absmach/quarc/docs/prd.md

# QUARC — Post-Quantum Secure Element

## Product Requirements Document v1.1 — 2025

### PROPRIETARY & CONFIDENTIAL

---

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

---

## Document Metadata

| Field | Value |
| --- | --- |
| Document | Quarc PRD v1.1 |
| Status | DRAFT |
| Classification | Public — open source |
| FPGA Board | ULX3S — Lattice ECP5-85K (84K LUTs) + BeagleV-Fire — PolarFire MPFS025T (23k LEs, Step 1) |
| CPU | Ibex RV32IMC (Apache 2.0, via sv2v + Yosys) |
| HDL Language | Verilog 2005 (all Quarc RTL) + sv2v for Ibex CPU only |
| Toolchain | Yosys + nextpnr + sv2v + SymbiYosys + Icarus — 100% open source |
| Build System | GNU Make — single Makefile |
| IP License Model | Apache-2.0 (firmware, tools, docs) + CERN-OHL-P 2.0 (RTL, gateware) — permissive OSS components only (MIT/ISC/BSD/Apache 2.0) |
| PQC Standards | FIPS 203 ML-KEM-768 \| FIPS 204 ML-DSA-65 |
| Comparable Product | TROPIC01 by Tropic Square — extended with PQC |
| Changelog | v1.1: PMP policy table, hardware key usage enforcement, device lifecycle model, secure boot rollback protection, NTT zeroization, entropy budgeting, bus protocol definition, concrete v1 use case |

---

## Table of Contents

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

---

## 1. Product Overview

### 1.1 Background and Motivation

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

### 1.2 What Quarc Is

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

### 1.3 What Quarc Is Not

- Not a clone of TROPIC01 — different crypto subsystem, same market positioning
- Not OpenTitan — deliberately lean, no SystemVerilog, no Bazel, fully open toolchain
- Not a finished product in v1 — v1 is an FPGA prototype proving architecture and PQC correctness
- Not a general-purpose MCU — Quarc is a cryptographic coprocessor, not a compute platform

### 1.4 Concrete v1 Use Case

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

```
1. Factory: Quarc generates ML-DSA keypair in slot 0 (device identity)
2. Factory: Quarc's verification key registered with update server
3. Field:   Update server generates new firmware, signs with its ML-DSA key
4. Field:   Host MCU initiates Quarc session (CHANNEL_INIT — Noise IK + ML-KEM hybrid)
5. Field:   Host sends firmware image + server signature to Quarc (FW_UPDATE)
6. Field:   Quarc verifies server signature using ML-DSA, checks rollback counter
7. Field:   Quarc flashes verified firmware, increments rollback counter
8. Field:   Host MCU requests device attestation (DSA_SIGN over device state)
9. Field:   Update server verifies device attestation using registered key
```

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

### 1.5 Competitive Positioning

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

---

## 2. Objectives

### 2.1 Primary Objectives (v1)

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

### 2.2 Secondary Objectives (v1)

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

### 2.3 Explicitly Out of Scope (v1)

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

---

## 3. Threat Model

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

### 3.1 Protected Assets

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

### 3.2 Threat Actors

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

### 3.3 Trust Boundary

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

**Inside the trust boundary:**

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

**Outside the trust boundary — treated as untrusted:**

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

### 3.4 Security Properties Required

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

---

## 4. System Architecture

### 4.1 Design Principles

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

### 4.2 SoC Architecture

```
Host MCU / Gateway (STM32, ESP32, any)
    |
    | SPI — encrypted Noise Protocol channel (ML-KEM + X25519 hybrid)
    |
    v
+------------------------------------------------------------+
|                    QUARC SoC (ECP5-85K)                    |
|                                                            |
|  Boot ROM (immutable)                                      |
|    → TRNG startup test                                     |
|    → PMP configure + lock (before firmware)               |
|    → ML-DSA verify firmware + rollback check              |
|    → jump to firmware                                      |
|                                                            |
|  Ibex RV32IMC  ←→  System Bus (Wishbone-lite, ~200 lines) |
|       |                                                    |
|  [Crypto Engine]     [Memory]          [Peripherals]       |
|  Keccak/SHAKE        IRAM (BRAM)       SPI slave           |
|  NTT engine          DRAM (BRAM)       UART (dev only)     |
|  ML-KEM ctrl         Boot ROM          Timer/WDT           |
|  ML-DSA ctrl         Key store ←─────── DMA only          |
|  TRNG + DRBG         (BRAM, HW access) Lifecycle reg       |
|  Key Usage Enforcer  Rollback counter  GPIO                |
+------------------------------------------------------------+

Key store access rule:
  Firmware:       NEVER reads key bytes — issues commands only
  Crypto engines: DMA key material directly from key store
  Bus decoder:    key store region blocked from firmware address space
```

### 4.3 Bus Architecture

Single-master Wishbone-lite bus. Ibex is the only bus master. All peripherals are bus slaves.

**Protocol:**

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

**DMA for crypto engines:**

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

**Formal verification targets for bus:**

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

### 4.4 Module Inventory and LUT Budget

> **Status:** The LUT estimates below date from the original single-partition
> plan and are **obsolete**. Measured synthesis after the ML-KEM hardware
> controller (`build/synth.log`) is **149,551 LUT4 + 58,901 FF** — the full
> hardware path exceeds both the ECP5-85K (84k) and PolarFire MPFS025T (23k).
> Quarc therefore uses a **two-step partition**: Step 1 (BeagleV-Fire, 23k)
> keeps crypto in C (`fw/mlkem_sw.c` over the SHA-3 + NTT MMIO engines) with a
> minimal fabric; Step 2 (ULX3S, 84k) returns the hardware ML-KEM/ML-DSA
> controllers, KUE, keystore, and SPI slave to fabric. See README § "Two-step
> deployment plan" for the authoritative partition. The table below documents
> the _estimated_ per-module cost for the Step 2 (hardware-accelerated) fabric.
> **Step 1 bring-up build** (ML-KEM + TRNG/DRBG removed, `build/synth_step1_v4.log`)
> measures **18,832 LUT4 + 10,554 FF** and fits the 23k MPFS025T.

| Module | Est. LUTs | Source | Notes |
| --- | --- | --- | --- |
| Ibex RV32IMC | ~3,500 | Apache 2.0 (OSS) | Control plane only. Not on crypto path. Synthesised via sv2v. |
| System Bus | ~200 | CERN-OHL-P 2.0 | Custom Wishbone-lite + formal verification. |
| Keccak/SHAKE engine | ~10,200 | CERN-OHL-P 2.0 | Shared by all consumers. Full-width 1600-bit round. |
| NTT engine (shared) | ~3,000 | CERN-OHL-P 2.0 | Parameterised for q=3329 and q=8380417. |
| ML-KEM-768 controller | ~1,500+ | CERN-OHL-P 2.0 | State machine. Drives NTT and Keccak engines. |
| ML-DSA-65 controller | ~2,000+ | CERN-OHL-P 2.0 | State machine. Rejection sampler. Drives NTT. |
| Key Usage Enforcer | ~200 | CERN-OHL-P 2.0 | HW policy engine. Enforces SIGN/DECAP/NO-EXPORT per slot. |
| TRNG | ~300 | CERN-OHL-P 2.0 | Ring oscillator. SP 800-90B RCT + APT health tests. |
| DRBG (SHAKE-256) | ~200 | CERN-OHL-P 2.0 | Auto-reseed from TRNG. Entropy budgeting enforced. |
| SPI slave | ~400 | CERN-OHL-P 2.0 | Mode 0/3. Command framing. 10 MHz target. |
| Key store controller | ~200 + BRAM | CERN-OHL-P 2.0 | BRAM-backed. DMA-only access from crypto engines. |
| Boot ROM | ~100 + BRAM | CERN-OHL-P 2.0 | Verilog ROM. PMP config. ML-DSA root key. Rollback counter. |
| Lifecycle state machine  | ~150 | CERN-OHL-P 2.0 | 4-state FSM. One-way transitions. HW enforced. |
| Rollback counter | ~100 | CERN-OHL-P 2.0 | Monotonic. BRAM-backed (v1). OTP in v2. |
| UART debug | ~200 | OSS (permissive) | Disabled in production bitstream. |
| Timer + WDT | ~150 | CERN-OHL-P 2.0 | RISC-V mtime/mtimecmp + 100ms watchdog. |
| IRAM / DRAM | BRAM only | Inferred | Separate address regions. No FPGA primitives. |
| **TOTAL (Step 2, est.)** | **~23,000+ LUT** | | Full-hardware path. Does NOT fit MPFS025T (23k); fits ECP5-85K. |

---

## 5. Security Policy

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

### 5.1 PMP Region Layout

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

**Boot sequence:**

```
Power on
  → TRNG health test (halt if fail)
  → Configure PMP regions 0–7
  → Set PMP LOCK bits on all regions
  → Load firmware from QSPI Flash into IRAM
  → ML-DSA.Verify(root_vk, fw_hash, fw_sig) — halt if fail
  → Check fw_version >= rollback_counter — halt if fail
  → Jump to firmware entry point
```

### 5.2 Hardware Key Usage Policy

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

**Key slot policy register (per slot, set at provisioning, hardware-enforced):**

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

**Operation flow (example: DSA_SIGN with slot 0):**

```
Firmware writes: KUE_CMD = {SIGN, slot=0, hash_ptr=...}
KUE checks:      slot 0 policy == SIGN_ONLY? → yes, proceed
KUE action:      DMA key bytes from key store → ML-DSA engine internal registers
                 (key bytes never appear on main bus)
KUE increments:  slot 0 use counter
ML-DSA engine:   performs signing using internal key registers
ML-DSA engine:   returns signature to output buffer (not key bytes)
KUE:             zeroises engine internal key registers after operation
Firmware reads:  signature from output buffer
```

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

### 5.3 Device Lifecycle Model

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

```
MANUFACTURING ──→ PROVISIONED ──→ LOCKED
      │                               │
      └──────────────────────────────→ RMA
```

**State definitions and command permissions:**

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

**Transition rules:**

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

### 5.4 Secure Boot Anti-Rollback

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

**Rollback counter:**

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

**Firmware header format (32-byte prefix, ML-DSA signature covers full image including header):**

```
[0:3]   magic       = 0x51415243  ("QARC")
[4:7]   fw_version  = monotonic integer, must be >= rollback_counter
[8:11]  fw_length   = length of firmware image in bytes
[12:15] reserved
[16:31] reserved
[32..]  firmware image
[end-2420..end]  ML-DSA-65 signature (2420 bytes) over bytes [0..end-2420]
```

### 5.5 NTT Scratchpad Zeroization

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

**Zeroization sequence:**

```
PQC operation completes
  → NTT controller asserts ZEROIZE signal
  → Counter walks through all scratchpad addresses: write 0x00000000
  → After all addresses zeroed: assert OP_DONE interrupt to Ibex
  → Firmware may now issue next command
```

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

### 5.6 Entropy Budget

PQC algorithms are entropy-hungry. The DRBG tracks entropy consumption per operation and enforces reseed policy.

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

**DRBG policy:**

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

---

## 6. Functional Requirements

### 6.1 ML-KEM Engine — FIPS 203, ML-KEM-768

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

#### 6.1.1 Required Operations

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

#### 6.1.2 Hardware Accelerated

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

#### 6.1.3 Security Requirements

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

---

### 6.2 ML-DSA Engine — FIPS 204, ML-DSA-65

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

#### 6.2.1 Required Operations

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

#### 6.2.2 Hardware Accelerated

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

#### 6.2.3 Security Requirements

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

---

### 6.3 Shared NTT Engine

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

---

### 6.4 Keccak / SHA-3 / SHAKE Engine

Keccak is the dependency of everything. Built first, verified first.

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

---

### 6.5 Entropy System

Entropy failure is catastrophic. The system is conservative by design. No fallback mode. Failure halts.

#### 6.5.1 TRNG

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

#### 6.5.2 DRBG

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

---

### 6.6 Secure Key Storage

#### 6.6.1 Key Slots

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

#### 6.6.2 Key Lifecycle

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

#### 6.6.3 v1 Limitations — Explicitly Acknowledged

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

---

### 6.7 Host Interface

#### 6.7.1 Physical Layer

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

#### 6.7.2 Encrypted Channel — Noise Protocol IK (Hybrid PQC)

The host channel uses the Noise Protocol Framework pattern IK. Key exchange upgraded to hybrid PQC.

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

#### 6.7.3 Command Set

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

---

### 6.8 Secure Boot

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

---

### 6.9 Firmware

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

---

## 7. Non-Functional Requirements

### 7.1 Performance Targets

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

### 7.2 Resource Budget

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

### 7.3 Security Requirements

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

### 7.4 Auditability Requirements

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

### 7.5 Toolchain and Build Requirements

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

---

## 8. Key Design Decisions

> These decisions are locked for v1. Revisiting them requires a formal PRD amendment.

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

---

## 9. Test and Verification Strategy

### 9.1 Verification Levels

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

### 9.2 KAT Requirements — Mandatory Before Integration

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

### 9.3 Formal Verification Targets

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

### 9.4 Security Simulation Tests

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

### 9.5 v1 Success Criteria — All Must Pass

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

---

## 10. Development Phases

> Each phase must pass its exit criteria before the next begins. No exceptions.

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

---

## 11. Toolchain Reference

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

> GPL applies only to the tools themselves — not to RTL or firmware produced by them.

### Makefile Structure

```makefile
# Ibex SV sources — converted to Verilog via sv2v (one step, cached)
IBEX_SV     = $(wildcard ibex/rtl/*.sv)
IBEX_V      = build/ibex.v

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

ALL_SRCS    = $(IBEX_V) $(QUARC_SRCS)

$(IBEX_V): $(IBEX_SV)
	mkdir -p build
	sv2v $(IBEX_SV) -w $(IBEX_V)

sim: $(IBEX_V)
	iverilog -o sim.vvp $(ALL_SRCS) tb/tb_top.v && vvp sim.vvp

synth: $(IBEX_V)
	yosys -p "synth_ecp5 -abc9 -json build/quarc.json" $(ALL_SRCS)

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

bitstream: pnr
	ecppack build/quarc.config build/quarc.bit

prog: bitstream
	openFPGALoader -b ulx3s build/quarc.bit

formal:
	sby -f formal/bus_decoder.sby
	sby -f formal/keccak.sby
	sby -f formal/trng_health.sby
	sby -f formal/pmp_config.sby
	sby -f formal/kue_policy.sby
	sby -f formal/lifecycle_fsm.sby
```

---

## 12. Risks and Mitigations

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

---

## 13. Future Roadmap

> v1 proves the architecture. Roadmap is contingent on v1 success criteria passing.

### 13.1 v2 — Hardened SE

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

### 13.2 v3 — TEE Root of Trust

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

### 13.3 ASIC Path

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

---

## 14. Glossary

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

---

_Quarc Secure Element // PRD v1.1 // 2025 // Apache-2.0 / CERN-OHL-P 2.0_
