absmach/quarc/fw/mlkem_kat.h

/* mlkem_kat.h - FIPS 203 ML-KEM-768 KAT expected values (generated). */
static const unsigned char kat_pk[1184] = {
    0x29, 0x8a, 0xa1, 0x0d, 0x42, 0x3c, 0x8d, 0xda, 0x06, 0x9d, 0x02, 0xbc, 0x59, 0xe6, 0xcd, 0xf0,
    0x3a, 0x09, 0x6b, 0x8b, 0x3d, 0xa4, 0xca, 0xb9, 0xb8, 0x0c, 0xa4, 0xa1, 0x49, 0x07, 0x67, 0x2c,
    0xce, 0xf1, 0xec, 0x4f, 0xaf, 0x23, 0x4a, 0x0b, 0xc5, 0xb7, 0xe9, 0xd4, 0x73, 0xf2, 0xb3, 0x13,
    0x3b, 0x3b, 0x26, 0xa1, 0xd1, 0x75, 0xcb, 0x67, 0xa7, 0x80, 0x59, 0x19, 0x69, 0x9c, 0x02, 0xf7,
    0x65, 0x31, 0xb9, 0x9c, 0x5f, 0x89, 0x18, 0x07, 0x04, 0xbb, 0x4c, 0xa4, 0x53, 0x5c, 0x5b, 0x89,
    0x72, 0x67, 0x9c, 0x66, 0x0a, 0x07, 0xc5, 0xe5, 0x14, 0xb8, 0x70, 0x09, 0xc8, 0x62, 0xeb, 0x8f,
    0x51, 0x57, 0x69, 0x5e, 0xfb, 0x3f, 0xc4, 0x0a, 0x9d, 0xef, 0x6b, 0x81, 0xc1, 0xcc, 0x02, 0xa2,
    0x49, 0xae, 0x4f, 0x09, 0x4a, 0xd0, 0xd9, 0xbd, 0x34, 0x85, 0xc1, 0xc1, 0xc6, 0x80, 0x80, 0x52,
    0x0a, 0x7c, 0x8c, 0x63, 0x20, 0x32, 0xce, 0xe7, 0x38, 0x15, 0x4e, 0x5c, 0x51, 0x76, 0xc0, 0x7d,
    0xa5, 0x60, 0x24, 0x77, 0x6a, 0x43, 0x0f, 0xe7, 0x6e, 0xac, 0xf6, 0x65, 0xa3, 0xf7, 0xb8, 0x32,
    0x10, 0x22, 0x15, 0xbc, 0x82, 0xf1, 0x09, 0x39, 0xc8, 0x35, 0x57, 0x04, 0x33, 0x6a, 0x8f, 0xac,
    0x1d, 0x81, 0xe4, 0xbb, 0x04, 0x85, 0xaa, 0x5d, 0x7c, 0x74, 0xd6, 0xb5, 0x9b, 0xbe, 0x5c, 0x5e,
    0x97, 0x2a, 0x0d, 0x8b, 0xac, 0x41, 0x1b, 0x55, 0xb5, 0xd5, 0x55, 0x7c, 0xd6, 0x80, 0xa1, 0xa8,
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
    0x23, 0x73, 0x0b, 0x15, 0x18, 0x9e, 0x7c, 0x98, 0x2b, 0x22, 0xd8, 0x96, 0xa9, 0x72, 0xda, 0x3c,
    0x2e, 0xe5, 0x29, 0xbb, 0x5f, 0xe6, 0x36, 0x30, 0xc9, 0xc2, 0xdd, 0xfb, 0x9d, 0x1e, 0x42, 0x63,
    0xa3, 0xd4, 0x9a, 0xf2, 0x83, 0x20, 0x53, 0xd9, 0x7e, 0xfa, 0x2b, 0xd1, 0x78, 0x2f, 0x25, 0xd7,
    0xb8, 0x64, 0xd6, 0xfb, 0x37, 0x08, 0xbf, 0xb9, 0xd4, 0xbc, 0x6c, 0x2c, 0xc6, 0x45, 0x8d, 0x4f,
    0x14, 0x59, 0x99, 0x5d, 0xb3, 0x87, 0xe8, 0xb5, 0x03, 0x82, 0x5a, 0x44, 0x96, 0xc7, 0x35, 0x25,
    0x2a, 0xa6, 0x30, 0xa1, 0xbc, 0xaa, 0x7a, 0x26, 0x74, 0x72, 0x73, 0x96, 0xdc, 0xaf, 0x67, 0x03,
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
};
static const unsigned char kat_ss[32] = {
    0x9c, 0xdd, 0xd0, 0x89, 0xff, 0xe7, 0x0e, 0x39, 0x96, 0xe7, 0x6f, 0x7c, 0x8d, 0x06, 0x74, 0x6d,
    0xf3, 0x4d, 0x07, 0xe8, 0x65, 0x7b, 0xc0, 0xfc, 0xf2, 0xbb, 0x0e, 0x1c, 0x30, 0x84, 0xae, 0xa1,
};
