absmach/quarc/tb/tb_entropy_soc.sv

// tb_entropy_soc.sv - SoC-level TRNG + DRBG test
//
// Boots the boot_entropy firmware (harvests TRNG words, reseeds the DRBG,
// generates output) and checks the UART for "ENT OK\r\n".

`timescale 1ns/1ps

module tb_entropy_soc;

    reg clk = 1'b0;
    always #20 clk = ~clk;

    wire uart_tx;
    reg  uart_rx   = 1'b1;
    reg  spi_sck   = 1'b0;
    reg  spi_mosi  = 1'b0;
    wire spi_miso;
    reg  spi_cs_n  = 1'b1;
    wire [2:0] led;

    quarc_top dut (
        .clk_25mhz (clk),
        .uart_rx   (uart_rx),
        .uart_tx   (uart_tx),
        .spi_sck   (spi_sck),
        .spi_mosi  (spi_mosi),
        .spi_miso  (spi_miso),
        .spi_cs_n  (spi_cs_n),
        .led       (led)
    );

    defparam dut.u_bus.u_boot_rom.ROM_FILE = "fw/boot_entropy.hex";

    localparam real BIT_NS = 1.0e9 / 115200.0;

    reg [7:0] rx_buf [0:15];
    integer   rx_count = 0;

    // no VCD dump: dumping the full SoC per cycle is too slow

    // ── UART monitor (115200 8N1) ────────────────────────────────────────────
    initial begin
        byte b;
        integer i;
        forever begin
            @(negedge uart_tx);
            #(BIT_NS * 1.5);
            b = 8'h00;
            for (i = 0; i < 8; i++) begin
                b[i] = uart_tx;
                #(BIT_NS);
            end
            rx_buf[rx_count % 16] = b;
            rx_count++;
            // "ENT OK"
            if (rx_count >= 6 &&
                rx_buf[(rx_count-6) % 16] == "E" &&
                rx_buf[(rx_count-5) % 16] == "N" &&
                rx_buf[(rx_count-4) % 16] == "T" &&
                rx_buf[(rx_count-3) % 16] == " " &&
                rx_buf[(rx_count-2) % 16] == "O" &&
                rx_buf[(rx_count-1) % 16] == "K") begin
                $display("[%0t] PASS: TRNG+DRBG firmware test passed", $time);
                $finish;
            end
            // "ENT FAIL"
            if (rx_count >= 8 &&
                rx_buf[(rx_count-8) % 16] == "E" &&
                rx_buf[(rx_count-7) % 16] == "N" &&
                rx_buf[(rx_count-6) % 16] == "T" &&
                rx_buf[(rx_count-5) % 16] == " " &&
                rx_buf[(rx_count-4) % 16] == "F" &&
                rx_buf[(rx_count-3) % 16] == "A" &&
                rx_buf[(rx_count-2) % 16] == "I" &&
                rx_buf[(rx_count-1) % 16] == "L") begin
                $display("[%0t] FAIL: TRNG+DRBG firmware test failed", $time);
                $finish;
            end
        end
    end

    // ── Watchdog ─────────────────────────────────────────────────────────────
    initial begin
        #100_000_000;   // 100 ms
        $display("[%0t] FAIL: timed out before entropy result", $time);
        $finish;
    end

endmodule
