absmach/quarc/(commit log)

2026-08-17 Enhance crypto features, add ML-KEM support, and update build for Beagle V Fire (#1)
    * build(makefile): exclude tracer files, add sv2v synthesis and pkg paths
    * build(makefile): pass through prim_clock_gating and tidy README
    * feat(sha3): add Keccak-f1600, SHA-3 wrapper, KATs and tests
    * feat(sha3): add SoC SHA-3 firmware, RTL and sim test
    * perf(sha3): use word RAM to infer EBR and register reads
    * perf(sha3): use a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
2026-08-24 Add BeagleV-Fire gateware and improve NTT testing (#2)
    * feat(boards): add BeagleV-Fire gateware, bring-up docs & tools
    * test(bench): add self-checks and output checksums for NTT/SHA3
    * style(ntt): remove inline comments in OP_MUL
    * fix(ntt): add extra cycle to avoid read-before-write race
    * fix(ntt): pipeline basemul to split chained modq; update docs
    * docs(boards): move BeagleV-Fire docs into docs/guides and upda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
    [host_emu.c, ntt.v]
